mirartalt-dotcom/dzen-girya/stl/kak-pechatat.md

# Гиря-соты DZEN — как печатать (Fable, 12.09.2026)

Три детали, все лежат плоско, стол от 240 × 240 мм (Bambu P1S/X1, Creality K1, Prusa MK4 подходят).
Пластик — **PETG** (язычки должны пружинить; PLA треснет). Сопло **0,8** (быстро) или 0,6.

| Файл | Как класть | Поддержки | Слой | Стенки / заполнение | Пластик | Время (0,8 / 0,6) |
|---|---|---|---|---|---|---|
| 01 — Поддон | как есть, дном на стол | нет (перемычки над окнами 14 мм печатаются мостиком) | 0,4 / 0,3 | 2 периметра, 15 % | ≈ 95 г | ≈ 55 мин / 1,7 ч |
| 02 — Обруч | как есть, кольцом на стол, язычками вверх | нет (под зацепами скосы 45°) | 0,3 (мельче — язычки прочнее) | 2 периметра, 100 % (стенка 2,4 = 3 дорожки 0,8) | ≈ 45 г | ≈ 30 мин / 1 ч |
| 03 — Ручка (лёжа) | уже лежит плоским срезом вниз | **да, древовидные**: под ножками (5 мм над столом), спицами и медальоном | 0,4 / 0,3 | 2 периметра, **6–8 % gyroid** | ≈ 70 г + ≈ 8 г поддержек | ≈ 50 мин / 1,6 ч |
| **Итого** | | | | | **≈ 220 г** | **≈ 2,2 ч / 4,3 ч** |

Время — оценка по объёму пластика, слайсер покажет точнее (обычно ±20 %).

## В слайсере
- Импортировать каждый STL как **один объект** (если спросит «разделить на части?» — нет). Модель собрана из
  перекрывающихся тел, слайсер сам их объединяет.
- Ручка: включить поддержки, «только на столе» (support on build plate only), древовидные. Логотип на медальоне
  печатается вертикально, ему поддержки не нужны.
- Обруч: скорость наружных стенок пониже (30–40 мм/с) — язычки тонкие.
- Буквы и логотип на поясе — рельеф 1–1,6 мм наружу, печатаются свесом, слегка «мохнатые» снизу: нормально.

## Порядок
1. **Сначала** «STL/00 — Проба посадки банки» (полчаса): три кольца с зазорами. Банку завода никто не мерил, взят стандарт
   sleek Ø58,6 × 145. Если села с зазором не 30,5 — поправить `RR` в `soty_stl.py` и пересобрать (`python3 soty_stl.py`, 1 мин).
2. Поддон + обруч (можно вместе на одном столе 256 мм — не влезут, по очереди).
3. Ручка. После печати снять поддержки, проверить, что клинья на ножках пружинят (язычок 2,4 мм с прорезями 0,8).

## Сборка
Банки в поддон (6 по кругу, 7-я в центр) → обруч сверху до щелчка шести язычков → ручку ножками в стаканы до щелчка клиньев.
Снять ручку — нажать клин через окно стакана и потянуть вверх.

## Что не проверено
- Живой тест защёлок и прочности (расчётный запас ≥10×, см. страницу «Прочность»).
- Посадка ножки Ø16 в стакан Ø16: зазор в модели 0, слайсер/принтер обычно дают +0,2…0,3 мм. Если туго — шкурка;
  если болтается — `SOCK_R` оставить, `LEG_R` 8,0 → 8,15.
