mirartalt-dotcom/dzen-girya/stl/preview-back.png

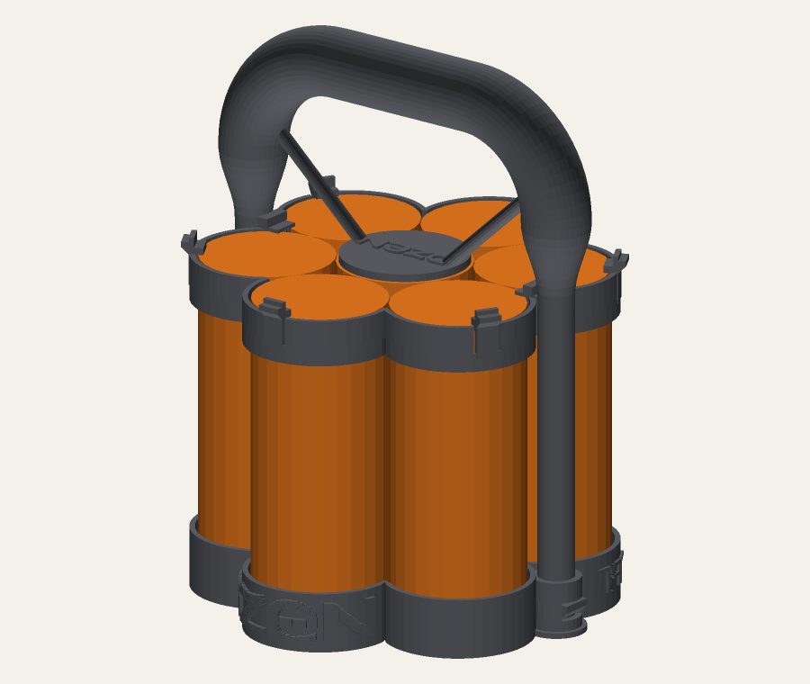
stl/preview-back.png
