mirartalt-dotcom/dzen-girya/stl/dzen-girya-02-obruch.stl

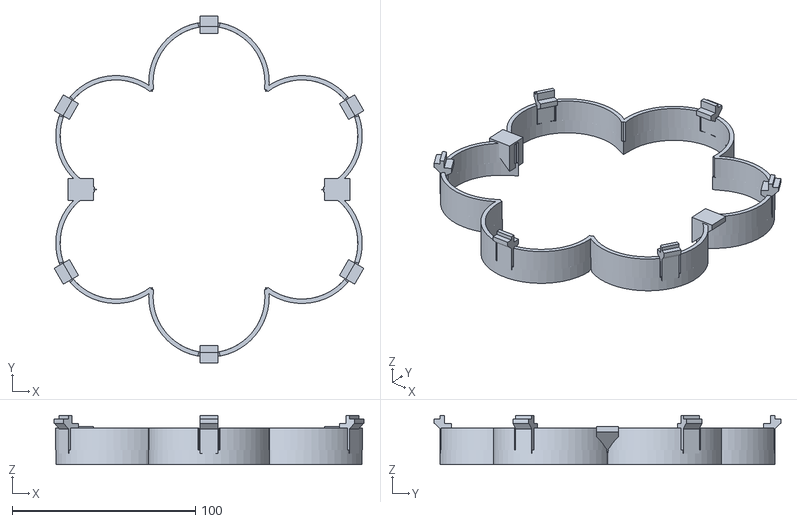
[picture p2: CAD file, 2026-11-11]
stl/dzen-girya-02-obruch.stl
169.0 x 189.4 x 27.0
