mirartalt-dotcom/dzen-girya/stl/dzen-girya-01-poddon.stl

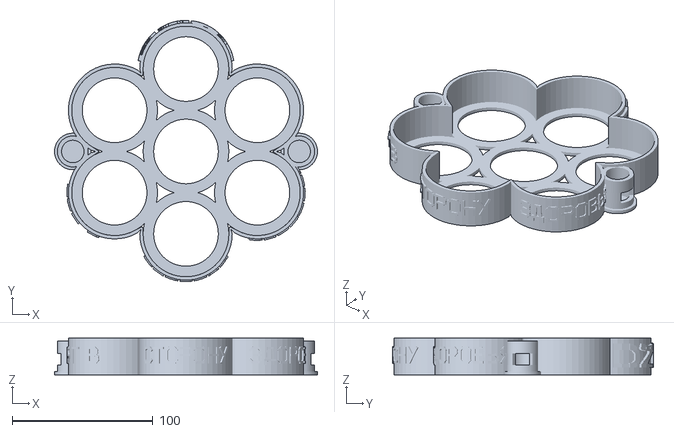
[picture p3: CAD file, 2026-11-11]
stl/dzen-girya-01-poddon.stl
187.0 x 185.8 x 26.0
