mirartalt-dotcom/dzen-girya/stl/dzen-girya-03-ruchka.stl

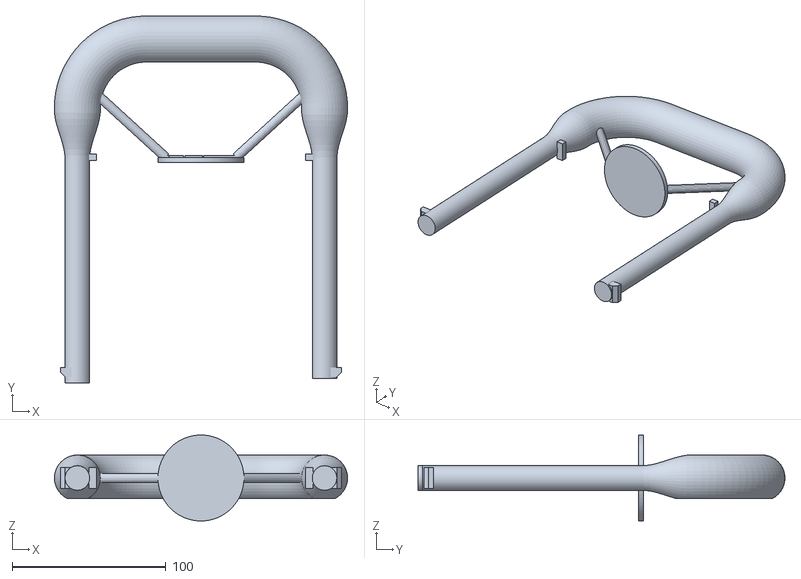
[picture p4: CAD file, 2026-11-11]
stl/dzen-girya-03-ruchka.stl
190.9 x 239.0 x 56.0
